hmallen/hab/Documents/Balloon Flight Analysis.pdf

# Balloon Flight Analysis

for Balloon Type B | 1 alloon
Steve Kliewer,
7/6/02

## Gondola & Rigging

## Flight String

## Drag

FoCroceefficsient of Drag Density of air

## Free Lift

## Tension

R is in
fFeeist in
feet
V is in knots

## The Minimum Upward Force and Inflation Radius

## Needed to lift to 90% of altitude

Find the minimum radius such that the balloon just reaches 900 ft with 1000 ft of string.

## Charts

Minimal Lift, Light Air, Line from 0 to 1000 ft

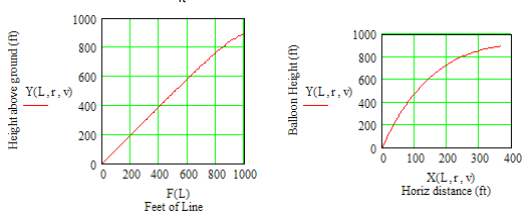
[picture p1: figure]

Inflation radius from 0 to 5 ft, Light Breeze, with 1000 ft of line

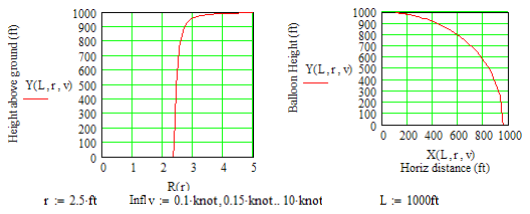
[picture p2: figure]

Minimum inflation, wind speeds from Calm to Gentle Breeze, and 1000 ft of line

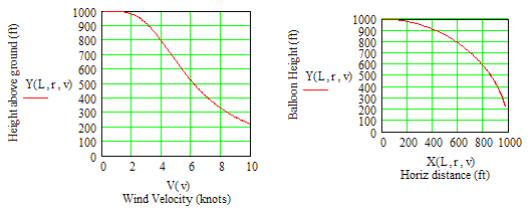
[picture p3: figure]

The Angle of the Line from Horizontal at ground level.

Wind 5 ft diameter 6 ft diameter 7 ft diameter
Speed Angle Altitude Angle Altitude Angel Altitude (Knots) (degrees) (feet) (degrees) (feet) (degrees) (feet)

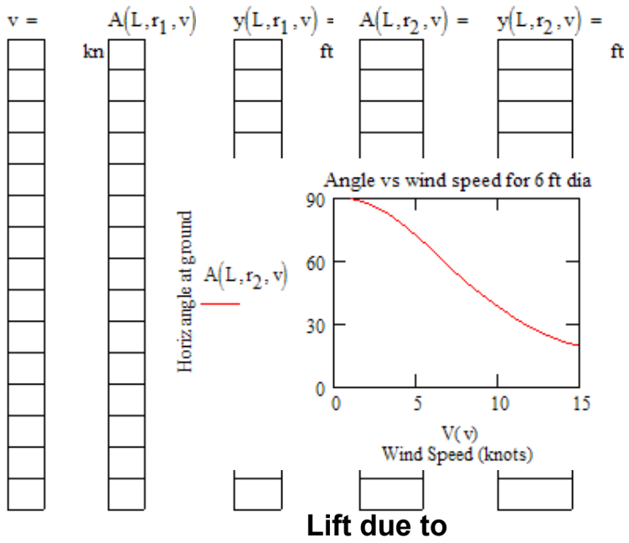
[picture p4: figure]

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
eliu

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
### Air Lift

p

e

r
v

olu

m

e
