hmallen/hab/Testing/arduino_testing/ms5607_test/ms5607_test.ino

#include <MS5xxx.h>
#include <Wire.h>

float ms5607Temp, ms5607Press;

MS5xxx ms5607(&Wire);

void setup() {
  Serial.begin(115200);

  if (ms5607.connect() > 0) {
    Serial.println("Error connecting...");
    delay(500);
    setup();
  }
}

void loop() {
  for (int x = 0; x < 3; x++) {
    ms5607.ReadProm();
    ms5607.Readout();

    ms5607Temp = ms5607.GetTemp() / 100.0;
    ms5607Press = ms5607.GetPres() / 100.0;

    delay(100);
  }

  Serial.print(ms5607Temp);
  Serial.print(" / ");
  Serial.println(ms5607Press);

  delay(2500);
}
