hmallen/hab/(commit log)

2016-10-03 Create Gas Sensors
2016-10-03 Update Gas Sensors
2016-10-04 Added framework.
2016-10-04 Continued work on framework.
2016-10-05 Updated framework.
2016-10-07 Added many/most sensors with verified sketch compilation.
2016-10-07 Completed addition of GPS, data logging, and major framework components. Untested.
2016-10-09 Fixed for new Adafruit GPS breakout.
    [hab.ino]
2016-10-14 Refined GPS startup fix check function.
    [hab.ino]
2016-10-26 Added altitude/pressure reference file.
2016-10-26 Began construction of loop framework. All functions working correctly.
    [hab.ino]
2016-10-27 Working on MS5607. Currently not functioning...likely due to breadboard wiring issues.
    [hab.ino]
2016-10-27 GPRS successfully integrated. Program stalls after ~5000 DOF loops.
    [hab.ino]
2016-10-27 Changed data read functions to return booleans to indicate success/failure.
    [hab.ino]
2016-10-28 Attempting fix of program stall on MS5607 read. Not fully tested.
    [hab.ino]
2016-10-28 Building heartbeat framework.
2016-10-29 Watchdog timer successfully integrated as Arduino Uno.
2016-10-30 Added TONS of features. Full function. Some bugs w/ power reset, etc and watchdog module.
    [hab.ino, hab_heartbeat.ino]
2016-11-01 Fixed SMS startup confirmation functions. Currently, debug SD logging of these data breaks program.
    [hab.ino]
2016-11-01 Fixed minor serial debug output issue.
    [hab.ino]
2016-11-01 Minor serial debug output formatting correction.
    [hab.ino]
2016-11-03 Added pin testing sketch to facilitate breakout hookup switch/LED testing and minor inline "to do" comments.
2016-11-04 Changed gas sensor warmup time and added extra LED startup indicators for debugging.
2016-11-04 Added some extra startup LED indicators and reduced gas sensor warmup time for field testing.
2016-11-18 Reduced gas sensor number to 6 based on payload hardware build.
2016-11-23 Minor formatting and line ending corrections.
    [hab.ino, rtty_test.ino]
2016-11-25 Added python script for camera control.
2016-11-25 Added basic framework for python camera script.
2016-11-28 Building on RPi camera capture framework and added test file.
2016-11-29 Working on python camera tests.
2016-11-29 Changed frame rate to 15 in video shell scripts.
2016-11-29 Merged webcam photo and video shell scripts for the two cameras. Incomplete.
2016-11-29 Fixed incorrect fswebcam device argument.
2016-11-29 Beginning work on main camera script.
2016-11-30 Integrating Arduino-RPi serial communication functions. Added working test scripts.
2016-12-01 Major progress on total framework of camera script.
2016-12-01 Integrating Arduino-->RPi serial calls for camera capture functions. Incomplete.
2016-12-02 Finished Arduino serial communication function integration. Untested.
2016-12-02 Modified main camera script to use shell scripts for picamera capture.
2016-12-04 Hardware testing in progress. Adding Arduino test sketches.
2016-12-04 Added more Arduino hardware test sketches.
2016-12-05 Added sketch for servo control by auxillary Arduino Nano, if needed.
2016-12-06 Continuing work on servo integration.
2016-12-06 Integrated servo output for photo deployment.
2016-12-06 Moved camera test script to "Testing" folder.
2016-12-06 Beginnign work on init.d script framework.
2016-12-07 More Arduino hardware test sketches.
2016-12-07 Working on Arduino hardware test sketches.
2016-12-11 Corrected incorrect "return" that was breaking MS5607 test sketch. Functional.
    [hab.ino, ms5607_test.ino]
2016-12-11 Fixed DS18B20 and relay activation in main HAB sketch.
    [ds_test.ino, hab.ino]
2016-12-11 Added boolean switch to disable payload heater activation functions.
2016-12-12 Changed main HAB sketch to use new DHT22 sensor. Added DS18B20 data validity confirmation to heater relay function.
2016-12-13 Testing Arduino<-->RPi serial data handling.
2016-12-13 Arduino sketch for serial data exchange testing.
2016-12-13 Added correct execute permissions to python script.
    [hab_camcontrol.py, serial_handling_test.py]
2016-12-13 Serial testing. Communication with Arduino functional.
2016-12-13 Improving test script in preparation for integration of actual camera functions.
2016-12-13 Beginning work on main RPi camera control script.
2016-12-13 Continuing work on main RPi camera control script.
2016-12-14 All serial communication test elements integrated into main camera control script. Untested.
2016-12-14 Added debug prints to script to signal enter/exit of each capture phase.
2016-12-14 Fixed lack of serial output from Arduino to Python when new phase function entered.
    [hab_camcontrol.py]
2016-12-14 Testing sudo within camera shell scripts.
2016-12-14 Fixed up camera control script.
    [hab.ino, hab_camcontrol.py]
2016-12-15 Added additional debug prints to main camera control script.
2016-12-15 Testing main camera control script with PiCam functions driven by python picamera library instead of shell script.
2016-12-15 Attempting fix of failure to capture PiCamera photos.
    [hab_camcontrol.py]
2016-12-15 Attempting fix of PiCamera photo capture at very low resolution.
    [hab_camcontrol.py]
2016-12-15 Corrected timing of video capture debug output messages.
    [hab_camcontrol.py]
2016-12-15 Eliminating secondary webcam photo capture during loops to prevent power failure during testing. Will use powered USB hub when available.
    [hab_camcontrol.py]
2016-12-15 Added debug prints to main HAB sketch.
2016-12-15 Debug pin testing sketch added.
2016-12-15 Fixing debug phase change functions.
    [hab_camcontrol.py]
2016-12-15 Trying to prevent additional function calls before video capture finished from another phase.
    [hab_camcontrol.py]
2016-12-15 Fixed debug pin actions.
    [hab.ino]
2016-12-15 Added debug prints to script.
2016-12-15 Removed extraneous serial prints to prevent buffer problems with RPi communication.
    [hab.ino]
2016-12-15 Working on new version of main camera control script.
2016-12-15 Finished new version of main camera control script. Untested.
2016-12-15 Replaced camera control script with new version and added execute permissions.
    [hab_camcontrol.py]
2016-12-15 Added timeout breaks to camera capture phase functions.
2016-12-15 Added debug output to camera control script.
2016-12-15 Added exception for system exit and keyboard interrupt to allow clean program shutdown.
2016-12-15 Added missing camera active boolean and additional debug prints.
    [hab_camcontrol.py]
2016-12-16 Fixing incorrect ordering of phase change function.
    [hab.ino]
2016-12-16 Fixed unsatisfiable logic condition preventing triggering of peak phase termination/descent phase.
    [hab.ino, hab_camservo.ino]
2016-12-16 Turned off debug mode in Arduino sketch.
2016-12-16 Fixed failure to enter pre-landing phase...again...I think.
2016-12-16 Implemented new camera control script. Mostly functional. Still testing.
2016-12-16 Testing python methods for persistent storage of current phase in case of RPi reboot.
    [persistent_phase_storage.py]
2016-12-16 Added file for camera control script to reference for current program phase.
2016-12-17 Integrating persistent mode storage into main camera control script.
2016-12-17 Functioning properly. Eliminating debug print.
2016-12-17 Was missing file writes on timeout and capture interval change on landing phase.
    [hab_camcontrol.py]
2016-12-17 Fixed improper boolean referencing preventing switch to landing capture/landing phase.
    [hab.ino]
2016-12-17 Fixed another improper boolean switch preventing activation of landing phase.
    [hab.ino]
2016-12-17 Rearranged altitude change functions to delay landing phase triggering.
2016-12-17 Cleaned-up SMS message output after landing phase triggering.
2016-12-17 Added absolute value to landing phase checks to prevent false negative change counts.
    [hab.ino]
2016-12-17 Cleaned-up SMS formatting on landing phase triggering.
2016-12-17 Changed to direct RPi to landing capture camera captures on descent mode.
2016-12-18 Testing selfie photo positioning on servo deployment.
2016-12-19 Added 30 skipped frames on webcam photo initialization to allow autofocus/brightness adjustment.
2016-12-26 Create Exterior_Sign_Ideas.txt
    Outline of signs to be mounted to exterior of payload.
2016-12-27 Added informational documents.
    [burst3.xls]
2016-12-31 Optimizing selfie servo program and hardware.
2017-01-03 Added shell scripts to log activity each minute and each reboot. Testing maximum time under battery power.
2017-01-11 Added Arduino sketch to video servo deployment. Continuing work on write-up.
2017-01-11 Increased servo deployment delay for video.
2017-01-19 Eliminated all program references to light sensor.
2017-01-20 Removed program header, references to light sensor, and extra unused analog gas sensor pins.
2017-01-23 Continuing work on code write-up. Cleaned up Arduino sketch headers.
